TheElk205/RotorTestingBench/Foto_Video/Unsorted/IMG_1583.JPG

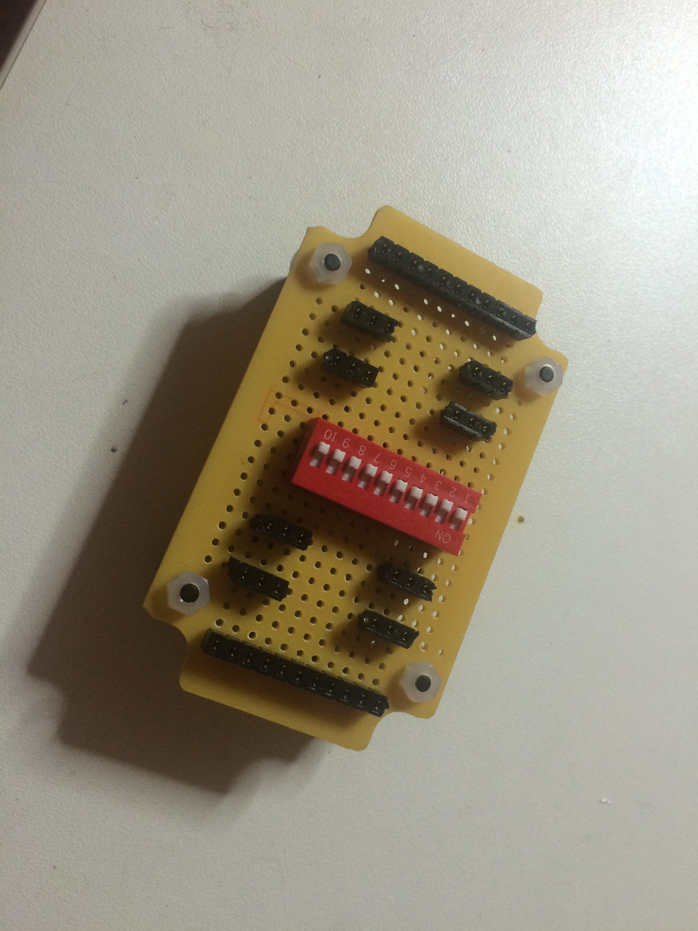
Foto_Video/Unsorted/IMG_1583.JPG
