TheElk205/RotorTestingBench/Foto_Video/Unsorted/IMG_1589.JPG

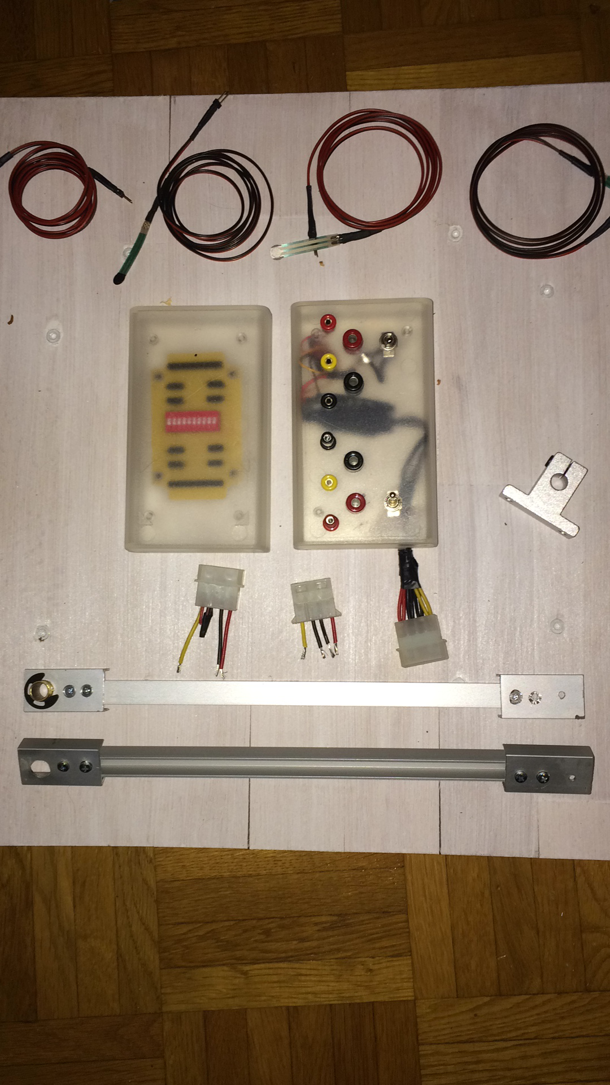
Foto_Video/Unsorted/IMG_1589.JPG
