TheElk205/RotorTestingBench/Foto_Video/Unsorted/IMG_1573.JPG

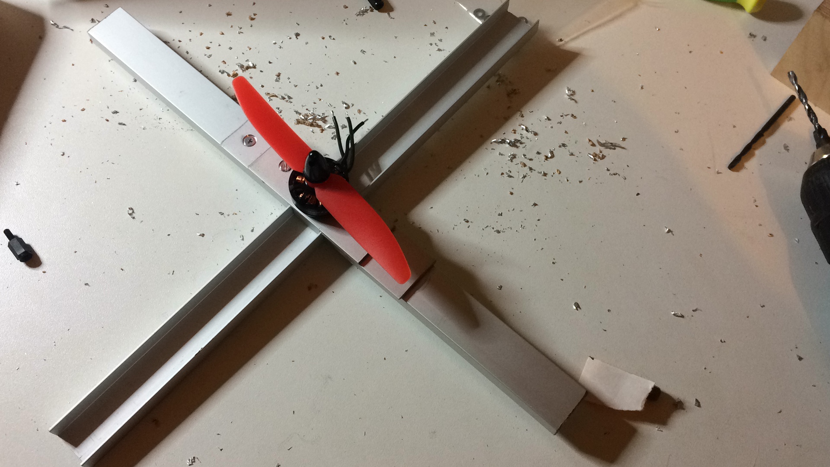
Foto_Video/Unsorted/IMG_1573.JPG
