TheElk205/RotorTestingBench/Foto_Video/Unsorted/IMG_1574.JPG

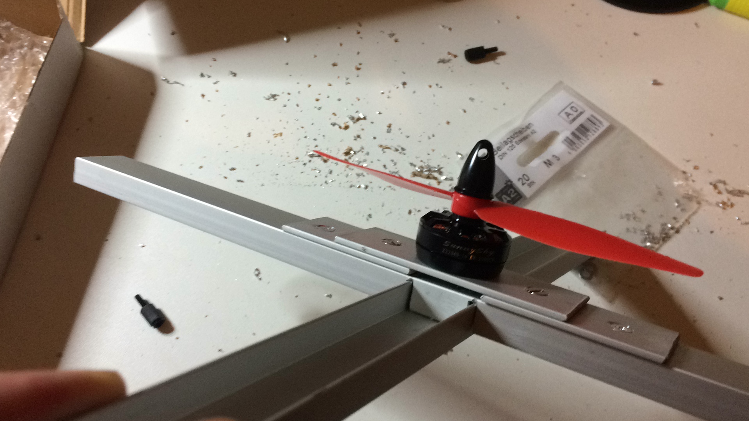
Foto_Video/Unsorted/IMG_1574.JPG
