TheElk205/RotorTestingBench/Foto_Video/Unsorted/IMG_1575.JPG

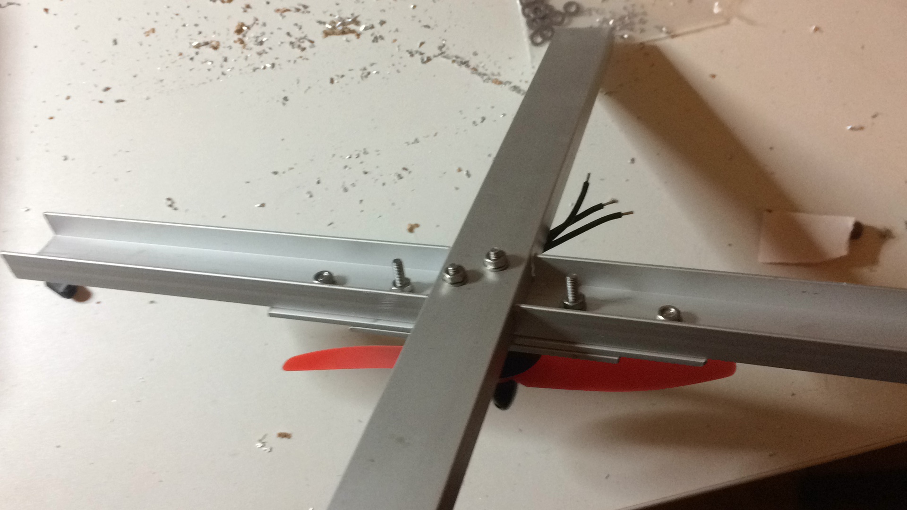
Foto_Video/Unsorted/IMG_1575.JPG
