TheElk205/RotorTestingBench/Foto_Video/Unsorted/IMG_1576.JPG

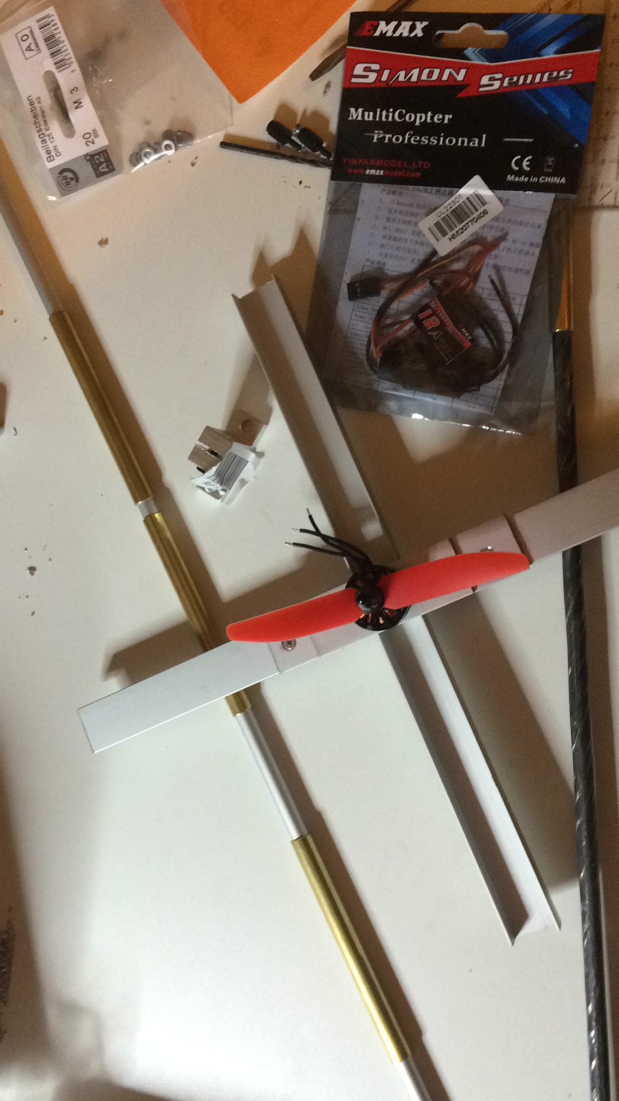
Foto_Video/Unsorted/IMG_1576.JPG
