TheElk205/RotorTestingBench/Foto_Video/Unsorted/IMG_1579.JPG

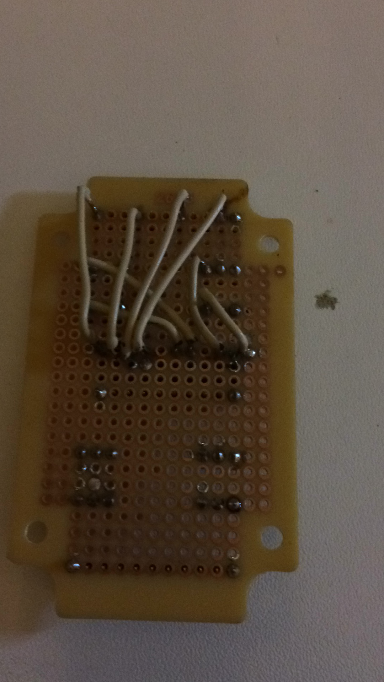
Foto_Video/Unsorted/IMG_1579.JPG
