TheElk205/RotorTestingBench/Foto_Video/Unsorted/IMG_1581.JPG

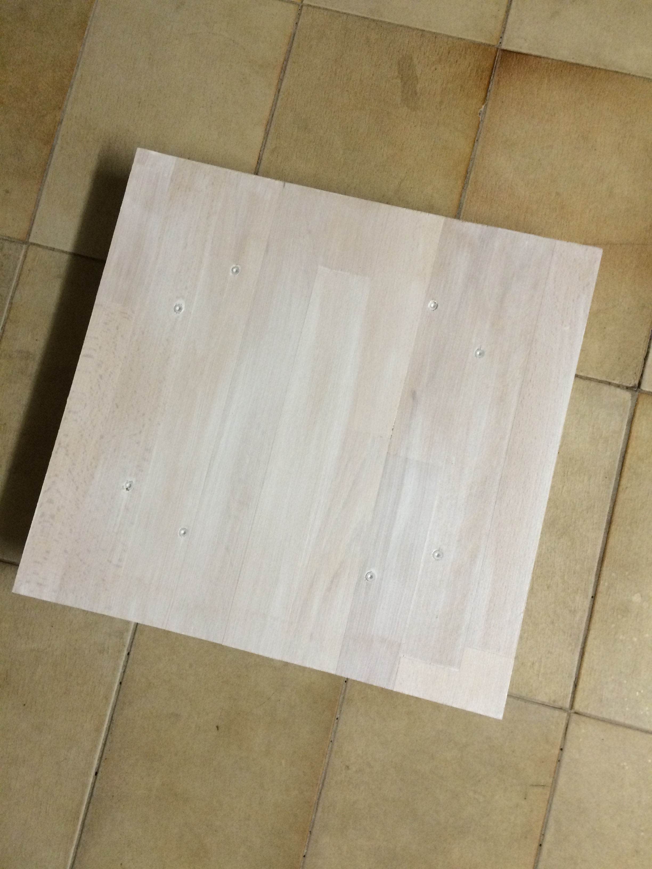
Foto_Video/Unsorted/IMG_1581.JPG
