TheElk205/RotorTestingBench/Foto_Video/Unsorted/IMG_1582.JPG

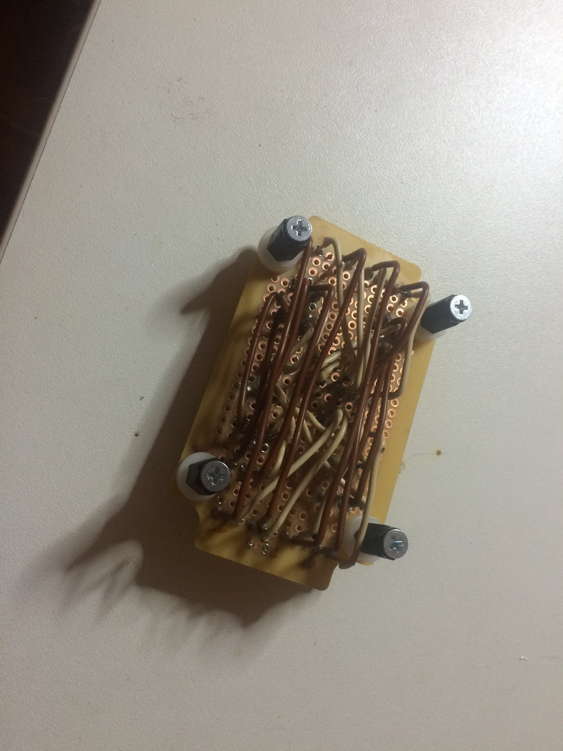
Foto_Video/Unsorted/IMG_1582.JPG
