TheElk205/RotorTestingBench/Foto_Video/Unsorted/IMG_1584.JPG

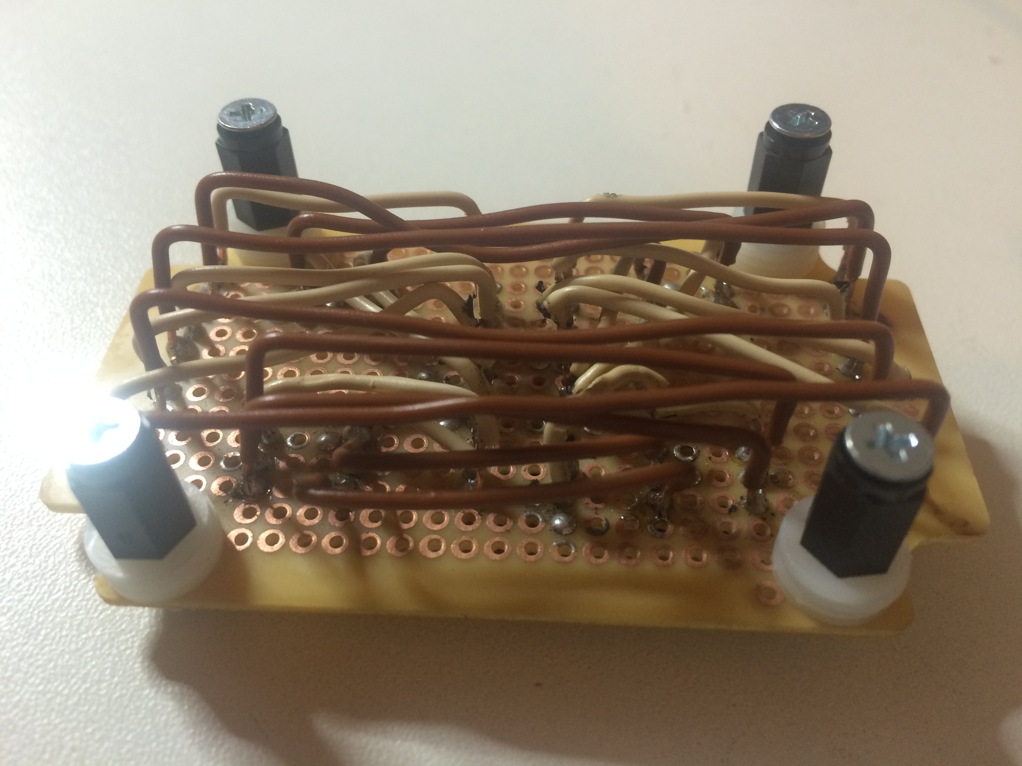
Foto_Video/Unsorted/IMG_1584.JPG
