TheElk205/RotorTestingBench/Foto_Video/Unsorted/IMG_1585.JPG

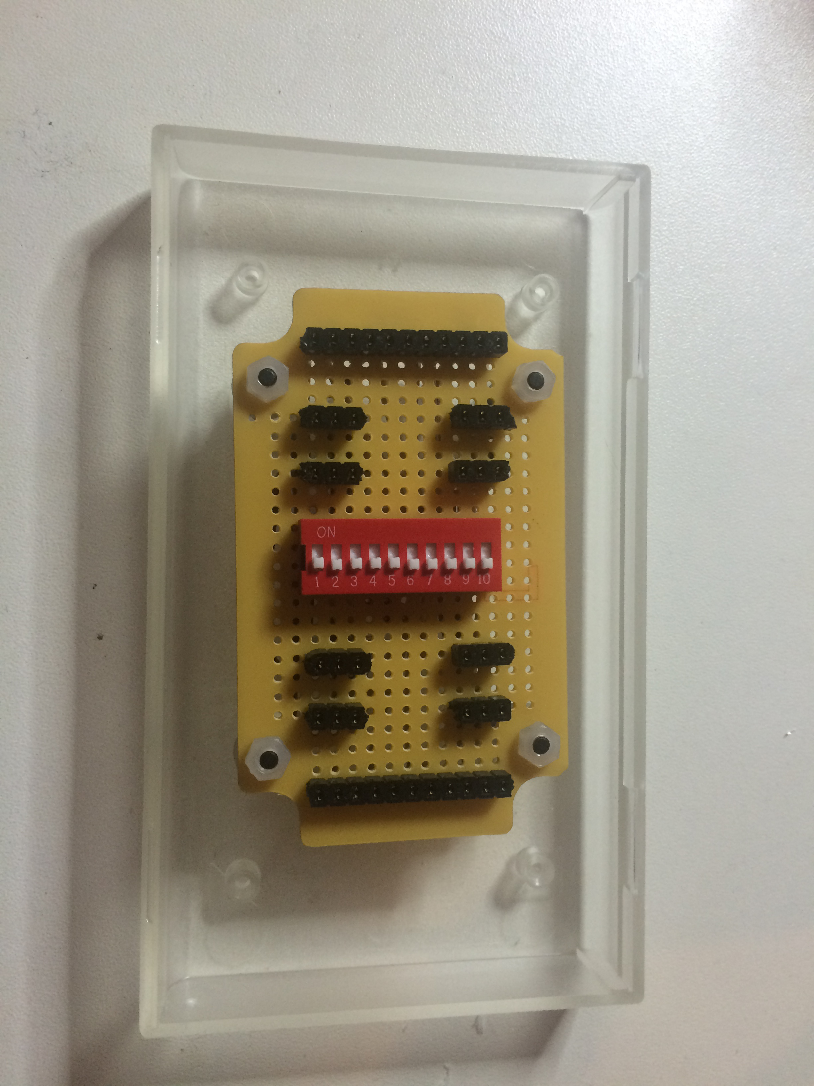
Foto_Video/Unsorted/IMG_1585.JPG
