TheElk205/RotorTestingBench/Foto_Video/Unsorted/IMG_1586.JPG

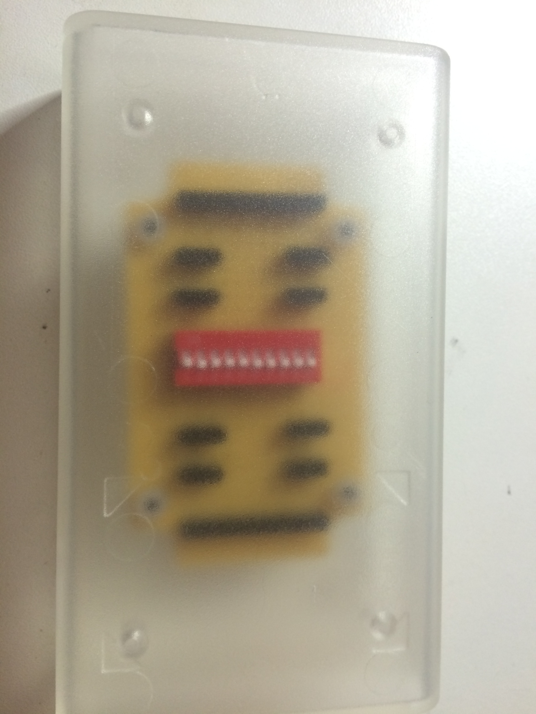
Foto_Video/Unsorted/IMG_1586.JPG
