TheElk205/RotorTestingBench/Foto_Video/Unsorted/IMG_1587.JPG

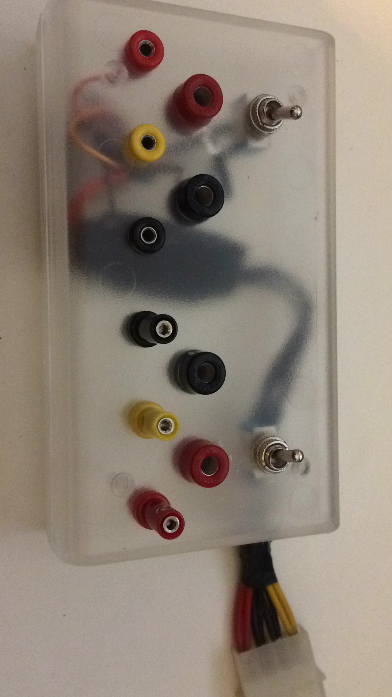
Foto_Video/Unsorted/IMG_1587.JPG
