TheElk205/RotorTestingBench/Foto_Video/Unsorted/IMG_1588.JPG

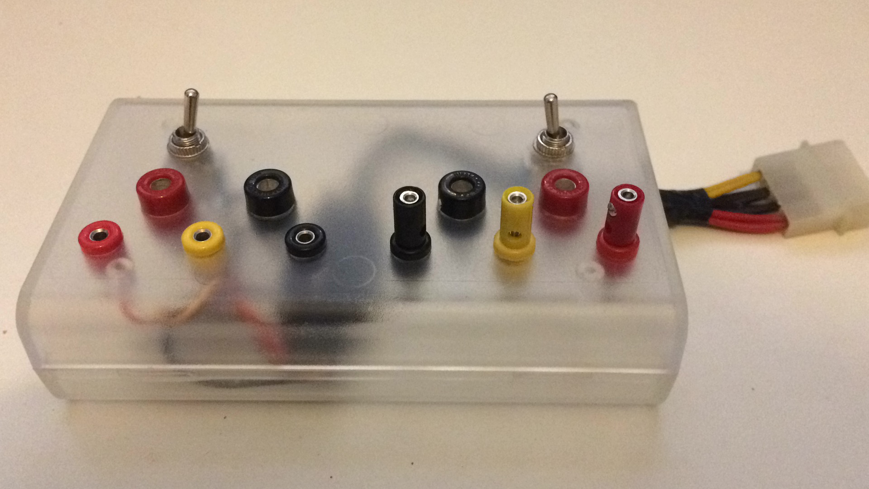
Foto_Video/Unsorted/IMG_1588.JPG
