TheElk205/RotorTestingBench/Foto_Video/Unsorted/IMG_1591.JPG

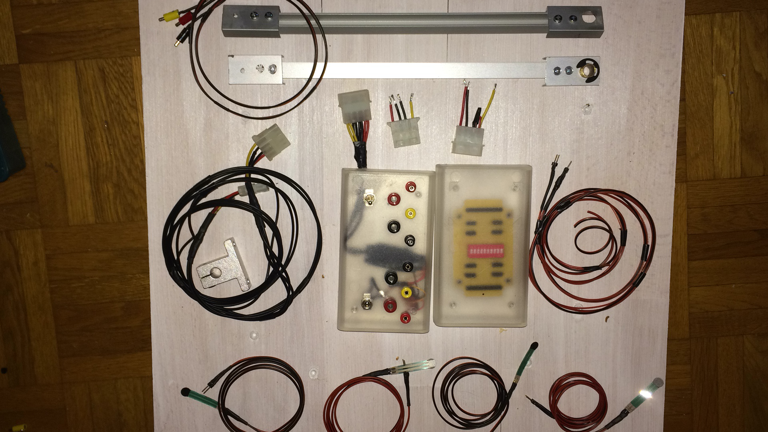
Foto_Video/Unsorted/IMG_1591.JPG
