TheElk205/RotorTestingBench/Foto_Video/Unsorted/IMG_1592.JPG

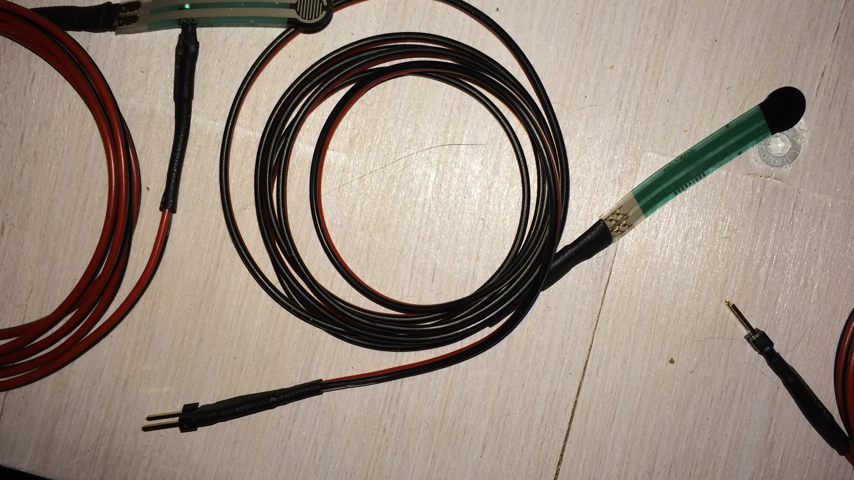
Foto_Video/Unsorted/IMG_1592.JPG
