TheElk205/RotorTestingBench/documentation/Material_TimelineV2_20161101.xlsx

Sheet: Materialkosten
Materialkosten Gesamt
Datum | ID | Artikel | Beschreibung | Lieferant | Baugruppe | â | Stück | Gesamt
2016-10-16 | RBS10262 | Drehzahlregler | EMAX Simon Series Brushless Speed Controller 12A | Roboter Bausatz Shop | Aufbau Prüfstand | 8.95 | 1 | 8.95
2016-10-16 | RBS10261 | Motor | SunnySky X2204S KV2300 Outrunner Brushless Motor CW | Roboter Bausatz Shop | Aufbau Prüfstand | 19.95 | 1 | 19.95
2016-10-16 | RBS10326 | Linearlager | SCE8UU Linearlager für 8mm Welle | Roboter Bausatz Shop | Aufbau Prüfstand | 2.95 | 4 | 11.80
2016-10-16 | RBS10283 | Propeller | Carbon Propeller 5X3 5030 (1xCW, 1xCCW) | Roboter Bausatz Shop | Aufbau Prüfstand | 3.95 | 1 | 3.95
2016-10-16 | RBS10541 | Halter | Wellenhalter 8mm | Roboter Bausatz Shop | Aufbau Prüfstand | 2.95 | 4 | 11.80
2016-10-16 |  | Versandkosten | Für Roboter Bausatz Shop | Roboter Bausatz Shop | Aufbau Prüfstand | 7.99 | 1 | 7.99
2016-10-01 |  | Arduino Uno | Arduino Board Uno | Conrad | Analoge Signalverarbeitung | 27.24 | 1 | 27.24
2016-10-01 |  | Motorshield | Arduino Motorshield | Conrad | Analoge Signalverarbeitung | 28.43 | 1 | 28.43
2016-10-25 |  | Drucksensor | Drucksensor, Knopfform, Widerstandsmessung, 0,01N bis 10N - Sample Bestellung, kostenlose Lieferung | Interlink Electronics HongKong | Analoge Signalverarbeitung | 0.00 | 16 | 0.00
offen |  | Laser | Arduino Laser für Drehzahlmessung |  | Analoge Signalverarbeitung | 1.95 | 2 | 3.90
offen |  | Photodiode | Für Laserabtastung |  | Analoge Signalverarbeitung | 0.95 | 5 | 4.75
2016-10-21 |  | Aluflachprofil | Profilware: U-Profil, Flachprofil, Alurohr | Hornbach | Aufbau Prüfstand | 15.00 | 1 | 15.00
2016-10-21 |  | 8mm Welle | Alu | Hornbach | Aufbau Prüfstand | 5.90 | 4 | 23.60
2016-10-21 |  | Messingrohr | 10x1, Lagerung Einsteckhülsen | Hornbach | Aufbau Prüfstand | 8.70 | 1 | 8.70
2016-10-21 |  | Standfuß | Holz siehe Zeichnung, weiß lasiert | Hornbach | Aufbau Prüfstand | 5.00 | 1 | 5.00
2016-10-21 |  | Messingrohr | innen Durchmesser 8,1mm - Einsteckhülsen für Aluwellen | Hornbach | Aufbau Prüfstand | 7.90 | 1 | 7.90
2016-10-21 |  | Schrauben | M3… | Hagebaumarkt | Aufbau Prüfstand | 10.00 | 1 | 10.00
2016-10-25 |  | Linearlager | Innen 8mm; 10er Pack | Amazon | Aufbau Prüfstand | 9.87 | 1 | 9.87
2016-10-21 |  | Sicherung Lager | PZ und Außensegeringe | Amazon | Aufbau Prüfstand | 2.50 | 1 | 2.50
2016-10-25 |  | Kabel | starr 0,5² | Conrad | Verteiler Niederstrom | 0.10 | 2 | 0.20
2016-10-25 |  | Gehäuse | für Sensoren Steckplatine | Conrad | Motor Verteiler, Verteiler Niederstrom | 2.98 | 3 | 8.94
2016-10-25 |  | Platine | 7,5x10cm Lochplatine | Conrad | Verteiler Niederstrom | 3.98 | 1 | 3.98
2016-10-25 |  | Befestigung | Abstandmutter, Schrauben und Beilagen M3 | Hagebaumarkt | Motor Verteiler, Verteiler Niederstrom | 10.00 | 1 | 10.00
2016-10-25 |  | Kabel | 2-ploig 0,25², Sensoren | Conrad | Verkabelung | 0.42 | 20 | 8.40
2016-10-25 |  | ide-Stecker | 4-polig, Motor | Conrad | Verkabelung | 0.99 | 2 | 1.98
2016-10-25 |  | Kabel | 1-polig 1², Motor | Conrad | Verkabelung | 0.56 | 10 | 5.60
2016-10-25 |  | Schrumpfschlauch | to 1mm | Conrad | Verkabelung | 0.89 | 1.5 | 1.33
2016-10-31 |  | Laborleitung | 4mm, Bananenstecker | Conrad |  | 4.99 | 8 | 39.92
2016-10-25 |  | Schrumpfschlauch | to 2mm | Conrad | Verkabelung | 1.10 | 1 | 1.10
2016-10-31 |  | Netzteil | 500W, 12 und 5V | Conrad | Generator | 39.90 | 1 | 39.90
2016-10-25 |  | Laborstecker | 2,4mm, je 10x rot, gelb und sw | Conrad | Motor Verteiler, Verteiler Niederstrom | 0.32 | 30 | 9.60
2016-10-25 |  | Lötmaterial |  | Conrad | Motor Verteiler, Verteiler Niederstrom | 10.00 | 1 | 10.00
2016-10-25 |  | Laborbüchse | Bananenbüchse 4mm gelb, sw, rot Farben | Conrad | Motor Verteiler, Verteiler Niederstrom | 0.89 | 30 | 26.70
2016-10-25 |  | Laborbüchse | Bananenhülse 2,4mm gelb, sw, rot | Conrad | Motor Verteiler, Verteiler Niederstrom | 0.87 | 30 | 26.10
2016-10-25 |  | Schalter | Schalter 2-polig 20A | Conrad | Motor Verteiler, Verteiler Niederstrom | 2.89 | 9 | 26.01
2016-10-25 |  | Kabelbefestigung | Lötöse M6 | Conrad | Motor Verteiler, Verteiler Niederstrom | 0.08 | 30 | 2.40
2016-10-25 |  | ide-Stecker | 4- poilig Motor | Conrad | Motor Verteiler | 0.99 | 2 | 1.98
 |  |  |  |  |  | Buffer |  | 43.55
 |  |  |  |  |  | Gesamt |  | 479.02
Die Materialkosten sollten für V1 somit abgedeckt sein, sollten noch elektrische Bauteile für den Messaufbau benötigt werden,
wird hier wie bei den Drucksensoren eine kostenlose Sampellieferung angestrebt - keine Merhkosten.

Sheet: Material_kleineSchrift_Doku
Materialkosten Gesamt
Datum | ID | Artikel | Beschreibung | Lieferant | Baugruppe | â | Stück | Gesamt
2016-10-16 | RBS10262 | Drehzahlregler | EMAX Simon Series Brushless Speed Controller 12A | Roboter Bausatz Shop | Aufbau Prüfstand | 8.95 | 1 | 8.95
2016-10-16 | RBS10261 | Motor | SunnySky X2204S KV2300 Outrunner Brushless Motor CW | Roboter Bausatz Shop | Aufbau Prüfstand | 19.95 | 1 | 19.95
2016-10-16 | RBS10326 | Linearlager | SCE8UU Linearlager für 8mm Welle | Roboter Bausatz Shop | Aufbau Prüfstand | 2.95 | 4 | 11.80
2016-10-16 | RBS10283 | Propeller | Carbon Propeller 5X3 5030 (1xCW, 1xCCW) | Roboter Bausatz Shop | Aufbau Prüfstand | 3.95 | 1 | 3.95
2016-10-16 | RBS10541 | Halter | Wellenhalter 8mm | Roboter Bausatz Shop | Aufbau Prüfstand | 2.95 | 4 | 11.80
2016-10-16 |  | Versandkosten | Für Roboter Bausatz Shop | Roboter Bausatz Shop | Aufbau Prüfstand | 7.99 | 1 | 7.99
2016-10-01 |  | Arduino Uno | Arduino Board Uno | Conrad | Analoge Signalverarbeitung | 27.24 | 1 | 27.24
2016-10-01 |  | Motorshield | Arduino Motorshield | Conrad | Analoge Signalverarbeitung | 28.43 | 1 | 28.43
2016-10-25 |  | Drucksensor | Drucksensor, Knopfform, Widerstandsmessung, 0,01N bis 10N - Sample Bestellung, kostenlose Lieferung | Interlink Electronics HongKong | Analoge Signalverarbeitung | 0.00 | 16 | 0.00
offen |  | Laser | Arduino Laser für Drehzahlmessung |  | Analoge Signalverarbeitung | 1.95 | 2 | 3.90
offen |  | Photodiode | Für Laserabtastung |  | Analoge Signalverarbeitung | 0.95 | 5 | 4.75
2016-10-21 |  | Aluflachprofil | Profilware: U-Profil, Flachprofil, Alurohr | Hornbach | Aufbau Prüfstand | 15.00 | 1 | 15.00
2016-10-21 |  | 8mm Welle | Alu | Hornbach | Aufbau Prüfstand | 5.90 | 4 | 23.60
2016-10-21 |  | Messingrohr | 10x1, Lagerung Einsteckhülsen | Hornbach | Aufbau Prüfstand | 8.70 | 1 | 8.70
2016-10-21 |  | Standfuß | Holz siehe Zeichnung, weiß lasiert | Hornbach | Aufbau Prüfstand | 5.00 | 1 | 5.00
2016-10-21 |  | Messingrohr | innen Durchmesser 8,1mm - Einsteckhülsen für Aluwellen | Hornbach | Aufbau Prüfstand | 7.90 | 1 | 7.90
2016-10-21 |  | Schrauben | M3… | Hagebaumarkt | Aufbau Prüfstand | 10.00 | 1 | 10.00
2016-10-25 |  | Linearlager | Innen 8mm; 10er Pack | Amazon | Aufbau Prüfstand | 9.87 | 1 | 9.87
2016-10-21 |  | Sicherung Lager | PZ und Außensegeringe | Amazon | Aufbau Prüfstand | 2.50 | 1 | 2.50
2016-10-25 |  | Kabel | starr 0,5² | Conrad | Verteiler Niederstrom | 0.10 | 2 | 0.20
2016-10-25 |  | Gehäuse | für Sensoren Steckplatine | Conrad | Motor Verteiler, Verteiler Niederstrom | 2.98 | 3 | 8.94
2016-10-25 |  | Platine | 7,5x10cm Lochplatine | Conrad | Verteiler Niederstrom | 3.98 | 1 | 3.98
2016-10-25 |  | Befestigung | Abstandmutter, Schrauben und Beilagen M3 | Hagebaumarkt | Motor Verteiler, Verteiler Niederstrom | 10.00 | 1 | 10.00
2016-10-25 |  | Kabel | 2-ploig 0,25², Sensoren | Conrad | Verkabelung | 0.42 | 20 | 8.40
2016-10-25 |  | ide-Stecker | 4-polig, Motor | Conrad | Verkabelung | 0.99 | 2 | 1.98
2016-10-25 |  | Kabel | 1-polig 1², Motor | Conrad | Verkabelung | 0.56 | 10 | 5.60
2016-10-25 |  | Schrumpfschlauch | to 1mm | Conrad | Verkabelung | 0.89 | 1.5 | 1.33
2016-10-31 |  | Laborleitung | 4mm, Bananenstecker | Conrad |  | 4.99 | 8 | 39.92
2016-10-25 |  | Schrumpfschlauch | to 2mm | Conrad | Verkabelung | 1.10 | 1 | 1.10
2016-10-31 |  | Netzteil | 500W, 12 und 5V | Conrad | Generator | 39.90 | 1 | 39.90
2016-10-25 |  | Laborstecker | 2,4mm, je 10x rot, gelb und sw | Conrad | Motor Verteiler, Verteiler Niederstrom | 0.32 | 30 | 9.60
2016-10-25 |  | Lötmaterial |  | Conrad | Motor Verteiler, Verteiler Niederstrom | 10.00 | 1 | 10.00
2016-10-25 |  | Laborbüchse | Bananenbüchse 4mm gelb, sw, rot Farben | Conrad | Motor Verteiler, Verteiler Niederstrom | 0.89 | 30 | 26.70
2016-10-25 |  | Laborbüchse | Bananenhülse 2,4mm gelb, sw, rot | Conrad | Motor Verteiler, Verteiler Niederstrom | 0.87 | 30 | 26.10
2016-10-25 |  | Schalter | Schalter 2-polig 20A | Conrad | Motor Verteiler, Verteiler Niederstrom | 2.89 | 9 | 26.01
2016-10-25 |  | Kabelbefestigung | Lötöse M6 | Conrad | Motor Verteiler, Verteiler Niederstrom | 0.08 | 30 | 2.40
2016-10-25 |  | ide-Stecker | 4- poilig Motor | Conrad | Motor Verteiler | 0.99 | 2 | 1.98
 |  |  |  |  |  | Buffer |  | 43.55
 |  |  |  |  |  | Gesamt |  | 479.02
Die Materialkosten sollten für V1 somit abgedeckt sein, sollten noch elektrische Bauteile für den Messaufbau benötigt werden,
wird hier wie bei den Drucksensoren eine kostenlose Sampellieferung angestrebt - keine Merhkosten.

Sheet: Timeline
 |  | KW42 | KW43 | KW44 | KW45 | KW46 | KW47 | KW48 | KW49 | KW50 | KW51 | KW52 | KW1 | KW2 | KW3 | KW4 | KW5 | KW6 | KW7 | KW8
Phase 0 | Planung
 | Berechnung, Zeichnung
 | Stücklisten
Phase 1 | Prüfstand - Mechanik
 | Lagerungen und Befestigungs Stangen
 | Motor Befestigung
 | Kabel Führungen
 | Sensor Halterungen
Phase 2 | Analoge Signale
 | Verkabelung
 | Stromzufuhr
 | Umdrehungsmesser
 | Drucksensoren
Phase 3 | Arduino Auswertung
 | Python Codierung
 | Code Review
 | Grafische Darstellung der Daten
 | Speicherung der Daten
Phase 4 | Abstimmung
 | Verfeinern mechanisch
 | Verfeinern Auswertung
 | Tests
Phase 5 | Dokumentation
 | Erste Idee
 | Dokumentation Prüfstand
 | Dokumentation Arduino
 | Code Dokumentation
 | Zwischenbericht
 | Endbericht
 | Weiter Versionen
Phase 6 | Video and More
 | Musterdaten Auswertung und Abgleich Datenblatt
 | YouTube Video, Live Durchgang
 | Photo Doku
 | Akademische Aufbereitung
