TheElk205/RotorTestingBench/python/guiQt/testWindow.py

# -*- coding: utf-8 -*-

# Form implementation generated from reading ui file 'testWindow.ui'
#
# Created by: PyQt4 UI code generator 4.11.4
#
# WARNING! All changes made in this file will be lost!

from PyQt4 import QtCore, QtGui

try:
    _fromUtf8 = QtCore.QString.fromUtf8
except AttributeError:
    def _fromUtf8(s):
        return s

try:
    _encoding = QtGui.QApplication.UnicodeUTF8
    def _translate(context, text, disambig):
        return QtGui.QApplication.translate(context, text, disambig, _encoding)
except AttributeError:
    def _translate(context, text, disambig):
        return QtGui.QApplication.translate(context, text, disambig)

class Ui_MainWindow(object):
    def setupUi(self, MainWindow):
        MainWindow.setObjectName(_fromUtf8("MainWindow"))
        MainWindow.resize(264, 311)
        self.centralwidget = QtGui.QWidget(MainWindow)
        self.centralwidget.setObjectName(_fromUtf8("centralwidget"))
        self.verticalLayout = QtGui.QVBoxLayout(self.centralwidget)
        self.verticalLayout.setObjectName(_fromUtf8("verticalLayout"))
        self.listWidget = QtGui.QListWidget(self.centralwidget)
        self.listWidget.setObjectName(_fromUtf8("listWidget"))
        self.verticalLayout.addWidget(self.listWidget)
        self.horizontalLayout = QtGui.QHBoxLayout()
        self.horizontalLayout.setContentsMargins(-1, -1, -1, 0)
        self.horizontalLayout.setObjectName(_fromUtf8("horizontalLayout"))
        self.button_ok = QtGui.QPushButton(self.centralwidget)
        self.button_ok.setObjectName(_fromUtf8("button_ok"))
        self.horizontalLayout.addWidget(self.button_ok)
        self.button_cancel = QtGui.QPushButton(self.centralwidget)
        self.button_cancel.setObjectName(_fromUtf8("button_cancel"))
        self.horizontalLayout.addWidget(self.button_cancel)
        self.verticalLayout.addLayout(self.horizontalLayout)
        MainWindow.setCentralWidget(self.centralwidget)
        self.menubar = QtGui.QMenuBar(MainWindow)
        self.menubar.setGeometry(QtCore.QRect(0, 0, 264, 26))
        self.menubar.setObjectName(_fromUtf8("menubar"))
        MainWindow.setMenuBar(self.menubar)
        self.statusbar = QtGui.QStatusBar(MainWindow)
        self.statusbar.setObjectName(_fromUtf8("statusbar"))
        MainWindow.setStatusBar(self.statusbar)

        self.retranslateUi(MainWindow)
        QtCore.QMetaObject.connectSlotsByName(MainWindow)

    def retranslateUi(self, MainWindow):
        MainWindow.setWindowTitle(_translate("MainWindow", "MainWindow", None))
        self.button_ok.setText(_translate("MainWindow", "OK", None))
        self.button_cancel.setText(_translate("MainWindow", "Cancel", None))
