TheElk205/RotorTestingBench/(commit log)

2016-10-11 Initial commit, working real time graphs with simulated sensors
    [sampleData.csv]
2016-10-11 first doku
    Die Idee ganz kurz und knackig, die MAterialliste fehlt noch und von Dir
    im rote makierten Feld ein paar Worte zum Code
2016-10-17 addition docu
    [Material_Timeline.xlsx]
2016-10-24 datasheet voltage sensor circuite
    [VoltageDistributor.xlsx]
2016-10-25 Revert "datasheet voltage sensor circuite"
    This reverts commit fd162436b8e5d511457767b45e99e0f507b6ed44.
    [VoltageDistributor.xlsx]
2016-10-25 datasheet agein :)
    [VoltageDistributor.xlsx]
2016-10-25 adds to materiallist
    [Material_Timeline.xlsx]
2016-10-26 docu ahhhhhhhhhhhh
    [Material_Timeline.xlsx]
2016-10-26 new photos - sensor switch (done) :)
2016-10-30 Added arduino crc test
2016-11-01 new cost calaculation
    [Material_Timeline.xlsx, Material_TimelineV2_20161101.xlsx]
2016-11-01 First prototype, 4 Plots of analog values available
